garvita4/split/BOM.csv

Item | Qty | Supplier | Cost/item | Total Cost | link
ESP32-S3-WROOM-1 Module | 2 | Robu.in | $6.03 | $12.06 | https://robu.in/product/espressif-esp32-s3-wroom-1-n16r8-module/
NFC RFID Reader | 2 | IndianHobbyCenter | $1.47 | $2.94 | https://www.indianhobbycenter.com/products/rc522-mini-rfid-reader-writer-spi-s50-with-rfid-card-and-tag
PCB | 1 | Zbotic | $45.00 | $45.00 | https://zbotic.in/
1.8" TFT Display | 2 | Robu.in | $3.28 | $6.56 | https://robu.in/product/62060/
Cherry MX2A Mechanical Switches (₹391 / pack of 10). | 42 | meckeys | $0.41 | $17.22 | https://meckeys.com/shop/accessories/keyboard-accessories/key-switches/cherry-mx2a-switch/
1N4148WS SMD Diodes (SOD-323 Package). | 42 | surnom.com | $0.01 | $0.42 | https://www.sunrom.com/p/1n4148---1n4148ws---t4---smd---sod323-0805
EC11 Rotary Encoder | 2 | robu.in | $0.61 | $1.22 | https://robu.in/product/hongyan-ec11h-7ce15p1zd15f7-rotary-encoder-with-push-button-switch-vertical-plug-in-5-pin-360-degree/
0603 SMD Backlight LEDs. | 42 | ktron.in | $0.01 | $0.42 | https://www.ktron.in/product/smd-white-led-0603-package/
AO3400A N-Channel MOSFET | 2 | robu.in | $0.06 | $0.12 | https://robu.in/product/1-month-warranty-414/
SMD 16-pin connector | 4 | ktron.in | $0.06 | $0.24 | https://www.ktron.in/product/16-pin-usb-type-c-connector-smd/
10,000 mAh LiPo Battery | 2 | makerbazar.in | $4.23 | $8.46 | https://makerbazar.in/products/single-cell-3-7v-10000mah-lipo-battery
TP4056 IC | 2 | ktron.in | $0.05 | $0.10 | https://www.ktron.in/product/tp4056-ic/
ME6211A33M3G IC | 2 | Robu.in | $0.08 | $0.16 | https://robu.in/product/me6211c33m5g-n-microne-500ma-fixed-3-3v-positive-electrode-6v-sot-23-5-voltage-regulators-linear-low-drop-out-ldo-regulators-rohs/
SMD1206P050TF/13.2 (PTC) | 2 | Robu.in | $0.10 | $0.20 | https://robu.in/product/smd1206-050c-6v-bnstar-6v-40a-500ma-1a-1206-resettable-rohs/
SMD Push Switches | 4 | Robu.in | $0.05 | $0.20 | https://robu.in/product/tsa043a2026a-bzcn-3x4x2-5-50ma-round-button-50gf-12v-smd-tactile-switches-rohs/
Slide Switch | 2 | Robu.in | $0.03 | $0.06 | https://robu.in/product/1-month-warranty-254/
100Ω Resistor | 42 | ktron.in | $0.01 | $0.42 | https://www.ktron.in/product/resistor-100-ohms-1-1-8w-smd-0805/
10kΩ Resistor | 12 | ktron.in | $0.01 | $0.12 | https://www.ktron.in/product/resistor-10k-ohms-1-1-8w-smd-0805/
56kΩ Resistor | 4 | ktron.in | $0.01 | $0.04 | https://www.ktron.in/product/resistor-56k-ohms-1-1-8w-smd-0805/
5.1kΩ Resistor | 4 | ktron.in | $0.01 | $0.04 | https://www.ktron.in/product/resistor-5k1-ohms-5-1-8w-smd-0805/
1.2kΩ Resistor | 2 | ktron.in | $0.01 | $0.02 | https://www.ktron.in/product/resistor-1k2-ohms-1-1-8w-smd-0805/
10µF Capacitor | 10 | ktron.in | $0.08 | $0.80 | https://www.ktron.in/product/10uf-50v-multi-layered-ceramic-capacitor-mlcc-x5r-smd-0805-yageo-cc0805kkx5r9bb106/
1µF Capacitor | 2 | ktron.in | $0.09 | $0.18 | https://www.ktron.in/product/1uf-50v-multi-layered-ceramic-capacitor-yageo/
100nF Capacitor | 8 | ktron.in | $0.01 | $0.08 | https://www.ktron.in/product/100nf-25v-multi-layered-ceramic-capacitor/
Estimated total shipping | 1 |  |  | $0.00
