garvita4/split/CAD/FINAL.step

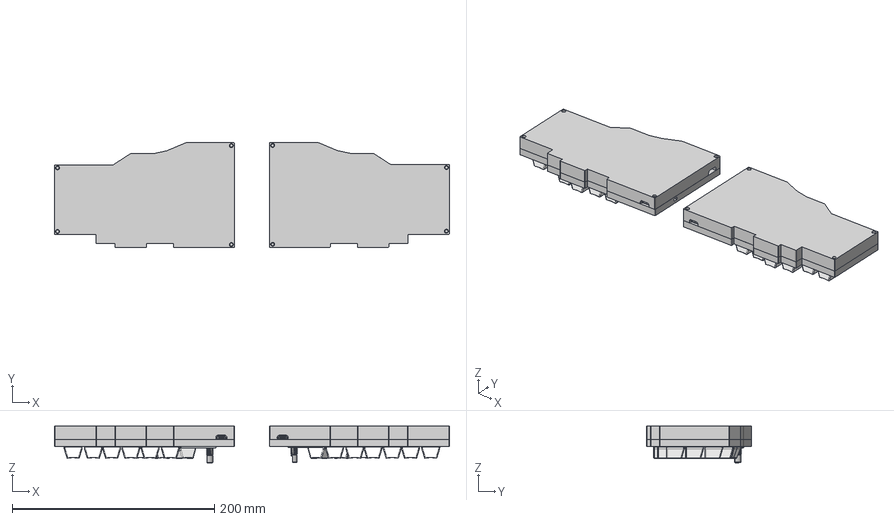
[picture p14: CAD file, 2026-11-13]
CAD/FINAL.step
391.0 x 104.2 x 36.2 mm
