garvita4/split/(list of files, cad)

Other CAD files:
CAD/final.f3z
