garvita4/split/JOURNAL.md

# Split keyboard: devlog

<!-- Generated by Half Life from project cmunp8sw5008x01lz6lry7mf8. Edits here are overwritten on the next sync. -->
<!-- Generated: 2026-11-13T12:07:09.205Z -->

> [!NOTE]
> This devlog is mirrored from [Half Life](https://halflife.hackclub.com) ([open the project](https://halflife.hackclub.com/projects/cmunp8sw5008x01lz6lry7mf8)). Editing it here will not change the platform's copy, and the next sync overwrites this file.

> This is a custom split keyboard with the 1.8inch tft dispaly and rotatory encoder and also with nfc based lock system with the controllable backlight . This keyboard can be used as wired keyboard as well as the wireless keyboard with the 2 bluetooth profile .

| Week | Tier | Hours logged | Entries |
| --- | --- | --- | --- |
| Week 1 | Tier 3 | 29.36h | 19 |

## Contents

1. [2026-10-06: Work session](#2026-10-06-work-session)
2. [2026-10-06: Work session](#2026-10-06-work-session)
3. [2026-10-06: Work session](#2026-10-06-work-session)
4. [2026-10-06: Work session](#2026-10-06-work-session)
5. [2026-10-06: Work session](#2026-10-06-work-session)
6. [2026-10-07: Work session](#2026-10-07-work-session)
7. [2026-10-07: Work session](#2026-10-07-work-session)
8. [2026-10-09: Work session](#2026-10-09-work-session)
9. [2026-10-09: Work session](#2026-10-09-work-session)
10. [2026-10-10: Work session](#2026-10-10-work-session)
11. [2026-10-10: Work session](#2026-10-10-work-session)
12. [2026-10-10: Work session](#2026-10-10-work-session)
13. [2026-10-10: Work session](#2026-10-10-work-session)
14. [2026-10-11: Work session](#2026-10-11-work-session)
15. [2026-10-11: Work session](#2026-10-11-work-session)
16. [2026-10-11: cad final](#2026-10-11-cad-finalhttpshalflifehackclub-assetscomhackclub-)
17. [2026-10-11: Worked on the firmware for the split keyboard…. It was quite tiring, and the code and logic were mind-bending…because I needed to make sure that all the parts worked together nicely and that the forma](#2026-10-11-worked-on-the-firmware-for-the-split-keyboard-it-)
18. [2026-11-02: Work session](#2026-11-02-work-session)
19. [2026-11-13: Work session](#2026-11-13-work-session)

## Design

### 2026-10-06: Work session

**2.63h**

[Timelapse](https://lookout.hackclub.com/api/media/fa09e0d1-9889-4a76-8786-f0ed05f4cb8e/video.mp4)

[Timelapse](https://lookout.hackclub.com/api/media/a4023034-a6c9-4dbe-ba91-8a4ed8cefd60/video.mp4)

### 2026-10-06: Work session

**2.48h**

[Timelapse](https://lookout.hackclub.com/api/media/238b4fb6-77a1-4ed1-8ca2-e7f95c66ffd1/video.mp4)

[Timelapse](https://lookout.hackclub.com/api/media/069fec37-b7f3-41dd-b589-08f1e135d678/video.mp4)

### 2026-10-06: Work session

**1.93h**

[Timelapse](https://lookout.hackclub.com/api/media/08d78c48-f7ff-4193-935c-75da801ebfcb/video.mp4)

[Timelapse](https://lookout.hackclub.com/api/media/c5cf219b-8f62-4002-8fa4-3c512989e7a5/video.mp4)

[Timelapse](https://lookout.hackclub.com/api/media/dbb9c82c-6322-4160-89b4-1992df5d9d32/video.mp4)

### 2026-10-06: Work session

**2.28h**

[Timelapse](https://lookout.hackclub.com/api/media/b292edbe-c17d-48f4-a8b2-611dfdaa1bf6/video.mp4)

[Timelapse](https://lookout.hackclub.com/api/media/a3bcac7a-56fe-46c6-9c0c-632a3be8ca45/video.mp4)

[Timelapse](https://lookout.hackclub.com/api/media/55e353d4-143c-44e7-a4cc-9b6b4d5bac2c/video.mp4)

### 2026-10-06: Work session

**1.38h**

[Timelapse](https://lookout.hackclub.com/api/media/4c44f54a-3c66-453c-81ff-a5ae66bed2b4/video.mp4)

[Timelapse](https://lookout.hackclub.com/api/media/eae46433-3b19-43af-acd8-854ccb4fdcb2/video.mp4)

[Timelapse](https://lookout.hackclub.com/api/media/4c8ac375-f49d-4045-93f7-460a7365f4d6/video.mp4)

### 2026-10-07: Work session

**0.75h**

[Timelapse](https://lookout.hackclub.com/api/media/b01193db-0a1d-46d9-8125-a0abd8dfa0e6/video.mp4)

[Timelapse](https://lookout.hackclub.com/api/media/5185ae71-8a5f-489b-9080-e3e37204f5e9/video.mp4)

[Timelapse](https://lookout.hackclub.com/api/media/f877c593-f8d2-43a6-9d64-0fafcc3788e7/video.mp4)

### 2026-10-07: Work session

**0.72h**

[Timelapse](https://lookout.hackclub.com/api/media/be486de2-89b2-4145-8a77-769001225c9e/video.mp4)

### 2026-10-09: Work session

**0.7h**

[Timelapse](https://lookout.hackclub.com/api/media/7c11e5da-b764-4344-a3d8-5f4837e74980/video.mp4)

[Timelapse](https://lookout.hackclub.com/api/media/6d3d7fa6-1e08-4c34-a48a-a156a17a32f6/video.mp4)

[Timelapse](https://lookout.hackclub.com/api/media/3061e0d2-355f-4172-82d1-556a65f0e97e/video.mp4)

[Timelapse](https://lookout.hackclub.com/api/media/ae54ebde-9d3e-429a-b00c-c6947ae5cabd/video.mp4)

[Timelapse](https://lookout.hackclub.com/api/media/de552aee-bf2f-4a00-a581-2f0484686022/video.mp4)

### 2026-10-09: Work session

**1.13h**

[Timelapse](https://lookout.hackclub.com/api/media/00b4dbc1-c776-4233-b0d5-e40b4433e9c5/video.mp4)

[Timelapse](https://lookout.hackclub.com/api/media/604f5c2d-8b02-4851-a766-cc941ec475c3/video.mp4)

### 2026-10-10: Work session

**3.2h**

[Timelapse](https://lookout.hackclub.com/api/media/8d58026e-1959-4ce2-8772-5496e367d459/video.mp4)

[Timelapse](https://lookout.hackclub.com/api/media/974f30a8-ac1b-46f6-ba75-7a7780001533/video.mp4)

### 2026-10-10: Work session

**1.88h**

[Timelapse](https://lookout.hackclub.com/api/media/f0266d8b-af8e-4a36-ad17-78c2cb34a42d/video.mp4)

### 2026-10-10: Work session

**3.07h**

[Timelapse](https://lookout.hackclub.com/api/media/e749b92d-0191-4098-8cd5-f2bc5531ad73/video.mp4)

[Timelapse](https://lookout.hackclub.com/api/media/9a701af2-79a5-4a7a-a52b-795ad1baed18/video.mp4)

### 2026-10-10: Work session

**1.33h**

[Timelapse](https://lookout.hackclub.com/api/media/7a5186ef-756c-472c-9491-e2284db1f771/video.mp4)

[Timelapse](https://lookout.hackclub.com/api/media/84f9cb65-f129-43c7-849b-16feeca2095c/video.mp4)

### 2026-10-11: Work session

**1.65h**

[Timelapse](https://lookout.hackclub.com/api/media/9649faf7-2c6e-4015-9647-146bb6c3372c/video.mp4)

[Timelapse](https://lookout.hackclub.com/api/media/45eea478-de85-45fe-9545-67b85143444f/video.mp4)

[Timelapse](https://lookout.hackclub.com/api/media/23b80925-42e8-4967-ae20-221c6497b499/video.mp4)

[Timelapse](https://lookout.hackclub.com/api/media/2c17d1e8-fca7-49b6-9bf4-ebd3f64c1d7d/video.mp4)

### 2026-10-11: Work session

**0.7h**

[Timelapse](https://lookout.hackclub.com/api/media/04fec4e5-41c3-48c8-ab6c-c5f673a822b0/video.mp4)

### 2026-10-11: cad final

**0.83h**

cad final

Worked on the CAD model of the keyboard in Fusion 360, and it was truly a hustle 😭. I spent around 40–50 minutes trying out things on my own, but I had a rough time doing so. Shaping the bottom and designing and arranging the switches was really tough for me, as I'm a total beginner in Fusion 360.
So, I had to take help from a friend who knew Fusion 360 well. He helped me design it.
It was challenging, but we completed it in the end.

cad2

### 2026-10-11: Worked on the firmware for the split keyboard…. It was quite tiring, and the code and logic were mind-bending…because I needed to make sure that all the parts worked together nicely and that the forma

**1.67h**

Worked on the firmware for the split keyboard…. It was quite tiring, and the code and logic were mind-bending…because I needed to make sure that all the parts worked together nicely and that the format supported all the elements used in the PCB I had designed…..
Improved it with the help of AI.
So now, the firmware is done too!

fm1

fm2

### 2026-11-02: Work session

**0.85h**

[Timelapse](https://lookout.hackclub.com/api/media/a61b71e2-01ce-4ea7-b090-80d0813ddedf/video.mp4)

[Timelapse](https://lookout.hackclub.com/api/media/531dd341-7c91-43c6-8fc3-8ffb226696bc/video.mp4)

### 2026-11-13: Work session

**0.18h**

[Timelapse](https://lookout.hackclub.com/api/media/3109d85c-96d9-438c-9e4a-fadaf278ae6c/video.mp4)
