garvita4/split/PCB/splitkeybaord.kicad_pcb

## KiCad design PCB/splitkeybaord.kicad_pcb (2026-11-13)

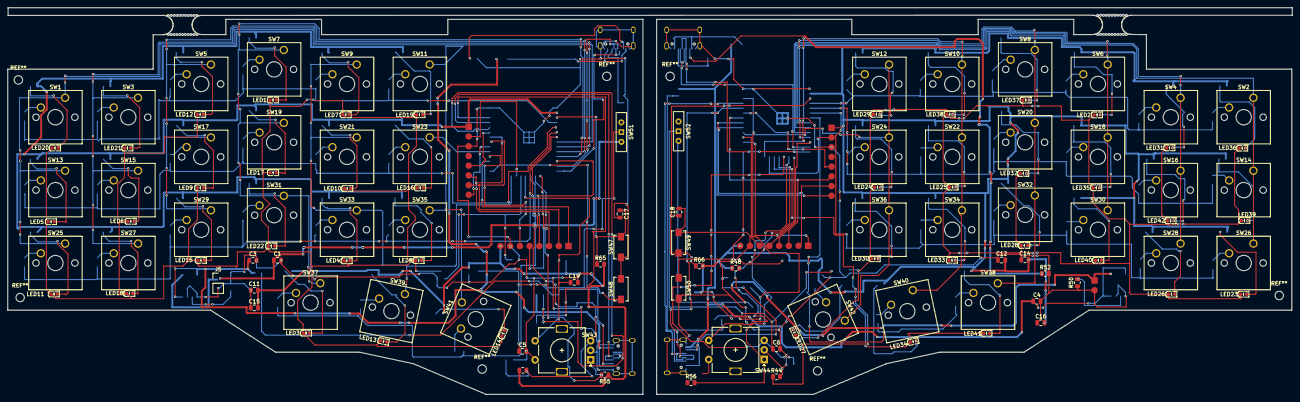
[picture p15: board splitkeybaord.kicad_pcb from above]

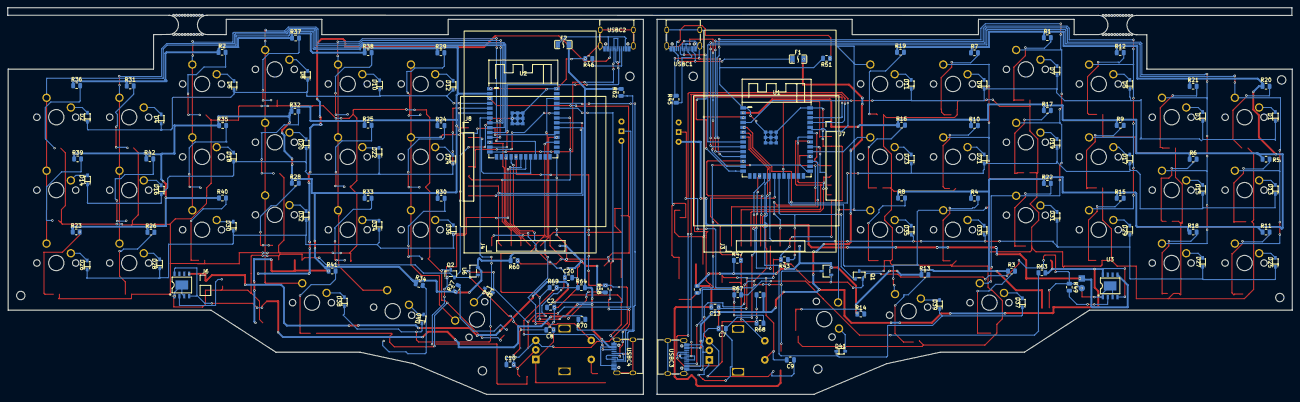
[picture p16: board splitkeybaord.kicad_pcb from below]

Board: 2 copper layers, 335.7 x 101.0 mm, 244 parts (127 on the bottom side), 166 nets.

Parts:
C1, C2, C5, C6, C11, C12, C13, C14: 10u; C_0805_2012Metric
C3, C4: 10U; C_0805_2012Metric
C7, C8, C9, C10, C15, C16, C19, C20: 100n; C_0805_2012Metric
C17, C18: 1u; C_0805_2012Metric
D1, D2, D3, D4, D5, D6, D7, D8, D9, D10, D11, D12, D13, D14, D15, D16, D17, D18, D19, D20, D21, D22, D23, D24, D25, D26, D27, D28, D29, D30, D31, D32, D33, D34, D35, D36, D37, D38, D39, D40, D41, D42: 1N4148WS T4; SOD-323_L1.8-W1.3-LS2.5-RD
F1, F2: SMD1206P050TF/13.2_C393935; F1206
J3, J4: TFTTT; PinHeader_1x08_P2.54mm_Vertical
J5, J6: BATT; PinHeader_1x02_P2.54mm_Vertical
J7, J8: NFC2; PinHeader_1x08_P2.54mm_Vertical
LED1, LED2, LED3, LED4, LED5, LED6, LED7, LED8, LED9, LED10, LED11, LED12, LED13, LED14, LED15, LED16, LED17, LED18, LED19, LED20, LED21, LED22, LED23, LED24, LED25, LED26, LED27, LED28, LED29, LED30, LED31, LED32, LED33, LED34, LED35, LED36, LED37, LED38, LED39, LED40, LED41, LED42: BL; LED0603-R-RD_WHITE
Q1, Q2: AO3400A; SOT-23-3_L2.9-W1.3-P1.90-LS2.4-BR
R1, R2, R3, R4, R5, R6, R7, R8, R9, R10, R11, R12, R13, R14, R15, R16, R17, R18, R19, R20, R21, R22, R23, R24, R25, R26, R27, R28, R29, R30, R31, R32, R33, R34, R35, R36, R37, R38, R39, R40, R41, R42: 0805; R_0805_2012Metric
R43, R44, R47, R48, R55, R56, R57, R58, R59, R60, R65, R66: 10k; R_0805_2012Metric
R45, R46, R51, R52, R61, R62, R63, R64: 5.1k; R_0805_2012Metric
R49, R50: 1.2K; R_0805_2012Metric
R67, R68, R69, R70: 56k; R_0805_2012Metric
SW1, SW2, SW3, SW4, SW5, SW6, SW7, SW8, SW9, SW10, SW11, SW12, SW13, SW14, SW15, SW16, SW17, SW18, SW19, SW20, SW21, SW22, SW23, SW24, SW25, SW26, SW27, SW28, SW29, SW30, SW31, SW32, SW33, SW34, SW35, SW36, SW37, SW38, SW39, SW40: SW_Push; SW_Cherry_MX_1.00u_PCB
SW41, SW42: SW_Push; SW_Cherry_MX_1.50u_PCB
SW43, SW44: RotaryEncoder_Switch; RotaryEncoder_Alps_EC11E-Switch_Vertical_H20mm
SW47, SW49: reset; SW_SPST_EVQPE1
SW48, SW50: boot; SW_SPST_EVQPE1
SW51, SW52: SW_Wuerth_450301014042; SW_Slide-03_Wuerth-WS-SLTV_10x2.5x6.4_P2.54mm
U1, U2: ESP32-S3-WROOM-1-N4R8; WIRELM-SMD_ESP32-S3-WROOM-1
U3, U4: TP4056_C725790; ESOP-8_L4.9-W3.9-P1.27-LS6.0-BL-EP
U5, U6: ME6211A33M3G-N; SOT-23-3_L2.9-W1.6-P1.90-LS2.8-BR
USBC1, USBC2: TYPE-C-31-M-12; USB-C_SMD-TYPE-C-31-M-12_1
USBC3, USBC4: J_LINK; USB-C_SMD-TYPE-C-31-M-12_1
mouse-bite-5mm-slot, mouse-bite-5mm-slot#2: VAL**; mouse-bite-5mm-slot

Connections:
+3.3V: C11.2, C12.2, C13.2, C14.2, C15.2, C16.2, J3.8, J4.8, J7.1, J8.1, R1.1, R2.1, R3.1, R4.1, R5.1, R6.1, R7.1, R8.1, R9.1, R10.1, R11.1, R12.1, R13.1, R14.1, R15.1, R16.1, R17.1, R18.1, R19.1, R20.1, R21.1, R22.1, R23.1, R24.1, R25.1, R26.1, R27.1, R28.1, R29.1, R30.1, R31.1, R32.1, R33.1, R34.1, R35.1, R36.1, R37.1, R38.1, R39.1, R40.1, R41.1, R42.1, R47.1, R48.1, R55.1, R56.1, R57.1, R58.1, R59.2, R60.2, R65.2, R66.2, U1.2 (3V3), U2.2 (3V3), U5.2 (VOUT), U6.2 (VOUT)
/left/5V_USB: C3.1, F1.2, R61.2, R63.2, U3.4 (VCC), U3.8 (CE), USBC3.A4B9 (VBUS), USBC3.B4A9 (VBUS)
/left/BACKLIGHT_PWM: Q1.1 (G), R43.1, U1.21 (IO13)
/left/COL0: SW1.1, SW13.1, SW25.1, U1.8 (IO15)
/left/COL1: SW3.1, SW15.1, SW27.1, U1.9 (IO16)
/left/COL2: SW5.1, SW17.1, SW29.1, U1.10 (IO17)
/left/COL3: SW7.1, SW19.1, SW31.1, SW37.1, U1.11 (IO18)
/left/COL4: SW9.1, SW21.1, SW33.1, SW39.1, U1.23 (IO21)
/left/COL5: SW11.1, SW23.1, SW35.1, SW41.1, U1.31 (IO38)
/left/ENCODER_A: C7.1, R55.2, SW43.A, U1.18 (IO10)
/left/ENCODER_B: C9.1, R57.2, SW43.B, U1.19 (IO11)
/left/ENCODER_SW: C19.1, R47.2, SW43.S1, U1.20 (IO12)
/left/HOST_PWR_EN: R67.1, R68.1, U1.38 (IO2)
/left/INTER_RX: U1.36 (RXD0), USBC3.A7 (DN1), USBC3.B7 (DN2)
/left/INTER_TX: U1.37 (TXD0), USBC3.A6 (DP1), USBC3.B6 (DP2)
/left/LED_CATHODE: LED1.2 (K), LED3.2 (K), LED4.2 (K), LED5.2 (K), LED6.2 (K), LED7.2 (K), LED8.2 (K), LED9.2 (K), LED10.2 (K), LED11.2 (K), LED12.2 (K), LED13.2 (K), LED14.2 (K), LED15.2 (K), LED16.2 (K), LED17.2 (K), LED18.2 (K), LED19.2 (K), LED20.2 (K), LED21.2 (K), LED22.2 (K), Q1.3 (D)
/left/ROW0: D1.1 (K), D3.1 (K), D5.1 (K), D7.1 (K), D9.1 (K), D11.1 (K), U1.4 (IO4)
/left/ROW1: D13.1 (K), D15.1 (K), D17.1 (K), D19.1 (K), D21.1 (K), D23.1 (K), U1.5 (IO5)
/left/ROW2: D25.1 (K), D27.1 (K), D29.1 (K), D31.1 (K), D33.1 (K), D35.1 (K), U1.6 (IO6)
/left/ROW3: D37.1 (K), D39.1 (K), D41.1 (K), U1.7 (IO7)
/left/SPI_CS: J7.8, U1.32 (IO39)
/left/SPI_MISO: J7.5, U1.35 (IO42)
/left/SPI_MOSI: J3.3, J7.6, U1.34 (IO41)
/left/SPI_RST: J7.2, U1.22 (IO14)
/left/SPI_SCK: J3.2, J7.7, U1.33 (IO40)
/left/TFT_CS: J3.6, U1.30 (IO37)
/left/TFT_DC: J3.4, U1.12 (IO8)
/left/TFT_PWM: J3.1, U1.29 (IO36)
/left/TFT_RST: J3.5, U1.17 (IO9)
/left/USB_D+: U1.14 (IO20), USBC1.A6 (DP1), USBC1.B6 (DP2)
/left/USB_D-: U1.13 (IO19), USBC1.A7 (DN1), USBC1.B7 (DN2)
/left/VBAT: C1.1, J5.1, SW51.3 (A), U3.5 (BAT)
/right/5V_USB: C4.1, F2.2, R62.2, R64.2, U4.4 (VCC), U4.8 (CE), USBC4.A4B9 (VBUS), USBC4.B4A9 (VBUS)
/right/BACKLIGHT_PWM: Q2.1 (G), R44.1, U2.21 (IO13)
/right/COL0: SW2.1, SW14.1, SW26.1, U2.8 (IO15)
/right/COL1: SW4.1, SW16.1, SW28.1, U2.9 (IO16)
/right/COL2: SW6.1, SW18.1, SW30.1, U2.10 (IO17)
/right/COL3: SW8.1, SW20.1, SW32.1, SW38.1, U2.11 (IO18)
/right/COL4: SW10.1, SW22.1, SW34.1, SW40.1, U2.23 (IO21)
/right/COL5: SW12.1, SW24.1, SW36.1, SW42.1, U2.31 (IO38)
/right/ENCODER_A: C8.1, R56.2, SW44.A, U2.18 (IO10)
/right/ENCODER_B: C10.1, R58.2, SW44.B, U2.19 (IO11)
/right/ENCODER_SW: C20.1, R48.2, SW44.S1, U2.20 (IO12)
/right/HOST_PWR_EN: R69.1, R70.1, U2.38 (IO2)
/right/INTER_RX: U2.36 (RXD0), USBC4.A7 (DN1), USBC4.B7 (DN2)
/right/INTER_TX: U2.37 (TXD0), USBC4.A6 (DP1), USBC4.B6 (DP2)
/right/LED_CATHODE: LED2.2 (K), LED23.2 (K), LED24.2 (K), LED25.2 (K), LED26.2 (K), LED27.2 (K), LED28.2 (K), LED29.2 (K), LED30.2 (K), LED31.2 (K), LED32.2 (K), LED33.2 (K), LED34.2 (K), LED35.2 (K), LED36.2 (K), LED37.2 (K), LED38.2 (K), LED39.2 (K), LED40.2 (K), LED41.2 (K), LED42.2 (K), Q2.3 (D)
/right/ROW0: D2.1 (K), D4.1 (K), D6.1 (K), D8.1 (K), D10.1 (K), D12.1 (K), U2.4 (IO4)
/right/ROW1: D14.1 (K), D16.1 (K), D18.1 (K), D20.1 (K), D22.1 (K), D24.1 (K), U2.5 (IO5)
/right/ROW2: D26.1 (K), D28.1 (K), D30.1 (K), D32.1 (K), D34.1 (K), D36.1 (K), U2.6 (IO6)
/right/ROW3: D38.1 (K), D40.1 (K), D42.1 (K), U2.7 (IO7)
/right/SPI_CS: J8.8, U2.32 (IO39)
/right/SPI_MISO: J8.5, U2.35 (IO42)
/right/SPI_MOSI: J4.3, J8.6, U2.34 (IO41)
/right/SPI_RST: J8.2, U2.22 (IO14)
/right/SPI_SCK: J4.2, J8.7, U2.33 (IO40)
/right/TFT_CS: J4.6, U2.30 (IO37)
/right/TFT_DC: J4.4, U2.12 (IO8)
/right/TFT_PWM: J4.1, U2.29 (IO36)
/right/TFT_RST: J4.5, U2.17 (IO9)
/right/USB_D+: U2.14 (IO20), USBC2.A6 (DP1), USBC2.B6 (DP2)
/right/USB_D-: U2.13 (IO19), USBC2.A7 (DN1), USBC2.B7 (DN2)
/right/VBAT: C2.1, J6.1, SW52.3 (A), U4.5 (BAT)
GND: C1.2, C2.2, C3.2, C4.2, C5.2, C6.2, C7.2, C8.2, C9.2, C10.2, C11.1, C12.1, C13.1, C14.1, C15.1, C16.1, C17.2, C18.2, C19.2, C20.2, J3.7, J4.7, J5.2, J6.2, J7.3, J8.3, Q1.2 (S), Q2.2 (S), R43.2, R44.2, R45.2, R46.2, R49.1, R50.1, R51.2, R52.2, SW43.C, SW43.S2, SW44.C, SW44.S2, SW47.1, SW48.2, SW49.1, SW50.2, U1.1 (GND), U1.40 (GND), U1.41 (GND), U2.1 (GND), U2.40 (GND), U2.41 (GND), U3.1 (TEMP), U3.3 (GND), U3.9 (EP), U4.1 (TEMP), U4.3 (GND), U4.9 (EP), U5.1 (VSS), U6.1 (VSS), USBC1.1 (EH), USBC1.2 (EH), USBC1.3 (EH), USBC1.4 (EH), USBC1.A1B12 (GND), USBC1.B1A12 (GND), USBC2.1 (EH), USBC2.2 (EH), USBC2.3 (EH), USBC2.4 (EH), USBC2.A1B12 (GND), USBC2.B1A12 (GND), USBC3.1 (EH), USBC3.2 (EH), USBC3.3 (EH), USBC3.4 (EH), USBC3.A1B12 (GND), USBC3.B1A12 (GND), USBC4.1 (EH), USBC4.2 (EH), USBC4.3 (EH), USBC4.4 (EH), USBC4.A1B12 (GND), USBC4.B1A12 (GND)
unnamed: D1.2 (A), SW1.2
unnamed: D2.2 (A), SW2.2
unnamed: D3.2 (A), SW3.2
unnamed: D4.2 (A), SW4.2
unnamed: D5.2 (A), SW5.2
unnamed: D6.2 (A), SW6.2
unnamed: D7.2 (A), SW7.2
unnamed: D8.2 (A), SW8.2
unnamed: D9.2 (A), SW9.2
unnamed: D10.2 (A), SW10.2
unnamed: D11.2 (A), SW11.2
unnamed: D12.2 (A), SW12.2
unnamed: D13.2 (A), SW13.2
unnamed: D14.2 (A), SW14.2
unnamed: D15.2 (A), SW15.2
unnamed: D16.2 (A), SW16.2
unnamed: D17.2 (A), SW17.2
unnamed: D18.2 (A), SW18.2
unnamed: D19.2 (A), SW19.2
unnamed: D20.2 (A), SW20.2
unnamed: D21.2 (A), SW21.2
unnamed: D22.2 (A), SW22.2
unnamed: D23.2 (A), SW23.2
unnamed: D24.2 (A), SW24.2
unnamed: D25.2 (A), SW25.2
unnamed: D26.2 (A), SW26.2
unnamed: D27.2 (A), SW27.2
unnamed: D28.2 (A), SW28.2
unnamed: D29.2 (A), SW29.2
unnamed: D30.2 (A), SW30.2
unnamed: D31.2 (A), SW31.2
unnamed: D32.2 (A), SW32.2
unnamed: D33.2 (A), SW33.2
unnamed: D34.2 (A), SW34.2
unnamed: D35.2 (A), SW35.2
unnamed: D36.2 (A), SW36.2
unnamed: D37.2 (A), SW37.2
unnamed: D38.2 (A), SW38.2
unnamed: D39.2 (A), SW39.2
unnamed: D40.2 (A), SW40.2
unnamed: D41.2 (A), SW41.2
unnamed: D42.2 (A), SW42.2
unnamed: F1.1, USBC1.A4B9 (VBUS), USBC1.B4A9 (VBUS)
unnamed: F2.1, USBC2.A4B9 (VBUS), USBC2.B4A9 (VBUS)
unnamed: LED1.1 (A), R1.2
unnamed: LED2.1 (A), R2.2
unnamed: LED3.1 (A), R3.2
unnamed: LED4.1 (A), R4.2
unnamed: LED5.1 (A), R5.2
unnamed: LED6.1 (A), R6.2
unnamed: LED7.1 (A), R7.2
unnamed: LED8.1 (A), R8.2
unnamed: LED9.1 (A), R9.2
unnamed: LED10.1 (A), R10.2
unnamed: LED11.1 (A), R11.2
unnamed: LED12.1 (A), R12.2
unnamed: LED13.1 (A), R13.2
unnamed: LED14.1 (A), R14.2
unnamed: LED15.1 (A), R15.2
unnamed: LED16.1 (A), R16.2
unnamed: LED17.1 (A), R17.2
unnamed: LED18.1 (A), R18.2
unnamed: LED19.1 (A), R19.2
unnamed: LED20.1 (A), R20.2
unnamed: LED21.1 (A), R21.2
unnamed: LED22.1 (A), R22.2
unnamed: LED23.1 (A), R23.2
unnamed: LED24.1 (A), R24.2
unnamed: LED25.1 (A), R25.2
unnamed: LED26.1 (A), R26.2
unnamed: LED27.1 (A), R27.2
unnamed: LED28.1 (A), R28.2
unnamed: LED29.1 (A), R29.2
unnamed: LED30.1 (A), R30.2
unnamed: LED31.1 (A), R31.2
unnamed: LED32.1 (A), R32.2
unnamed: LED33.1 (A), R33.2
unnamed: LED34.1 (A), R34.2
unnamed: LED35.1 (A), R35.2
unnamed: LED36.1 (A), R36.2
unnamed: LED37.1 (A), R37.2
unnamed: LED38.1 (A), R38.2
unnamed: LED39.1 (A), R39.2
unnamed: LED40.1 (A), R40.2
unnamed: LED41.1 (A), R41.2
unnamed: LED42.1 (A), R42.2
unnamed: C5.1, SW51.1 (B), U5.3 (VIN)
unnamed: C6.1, SW52.1 (B), U6.3 (VIN)
unnamed: C17.1, R65.1, SW47.2, U1.3 (EN)
unnamed: R59.1, SW48.1, U1.27 (IO0)
unnamed: C18.1, R66.1, SW49.2, U2.3 (EN)
unnamed: R60.1, SW50.1, U2.27 (IO0)
unnamed: R49.2, U3.2 (PROG)
unnamed: R50.2, U4.2 (PROG)
unnamed: R45.1, USBC1.A5 (CC1)
unnamed: R51.1, USBC1.B5 (CC2)
unnamed: R46.1, USBC2.A5 (CC1)
unnamed: R52.1, USBC2.B5 (CC2)
unnamed: R61.1, R68.2, USBC3.A5 (CC1)
unnamed: R63.1, R67.2, USBC3.B5 (CC2)
unnamed: R62.1, R70.2, USBC4.A5 (CC1)
unnamed: R64.1, R69.2, USBC4.B5 (CC2)
