garvita4/split/(commit log)

2026-11-13 fusion changes
    [FINAL.step, bom.csv, final.f3z, splitkeyboard.f3z]
2026-11-13 Sync Split keyboard from Half Life
    [BOM.csv]
